GuilhermePz337/Giga-de-Cabos-Automatizada/Tampa.SLDPRT

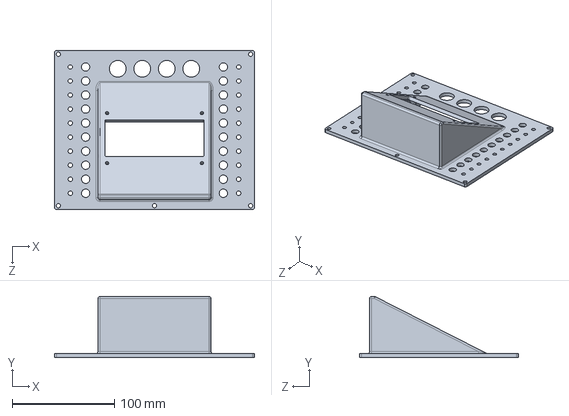
[picture p1: CAD file, 2025-10-20]
Tampa.SLDPRT
196.0 x 60.0 x 156.0 mm
