GuilhermePz337/Giga-de-Cabos-Automatizada/Base.SLDPRT

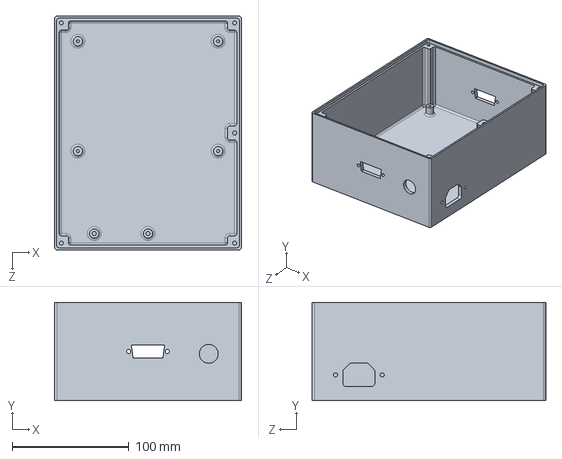
[picture p2: CAD file, 2025-10-20]
Base.SLDPRT
160.0 x 84.0 x 200.0 mm
