GuilhermePz337/Giga-de-Cabos-Automatizada/(list of files, drawings)

Other design files:
CircuitoTCC.DSN
